Clewsy/gps_clock/README.md

gps_clock has the following features and characteristics:
- 16 digit 7-segment LED display.
- Date/Time display [EPOCH][link_web_wikipedia_epoch_time] format (seconds elapsed since 1970-01-01).
- Date/Time display [ISO-8601][link_web_wikipedia_iso-8601] format (YYYY.MM.DD.HH.MM.SS).
- Adjustable brightness (setting retained with power-cycle).
- Programmable UTC offset from -12hrs to +12hrs in half-hour increments to match any timezone (setting retained with power-cycle).
- RTC with battery back-up to retain time with power-cycle and/or absence of GPS signal.

The [code][link_repo_code], schematics ([control board][link_repo_schematic_control] & [display board][link_repo_schematic_display]) and PCB layouts ([control board][link_repo_pcb_control] & [display board][link_repo_pcb_display]) are all included here on gitlab.

Additional info and photos can be found [here][link_clews_projects_gps_clock].

Proudly mentioned at [hackaday.com][link_web_hackaday_gpsclock] (and linked again in a [later article][link_web_hackaday_iso8601]).

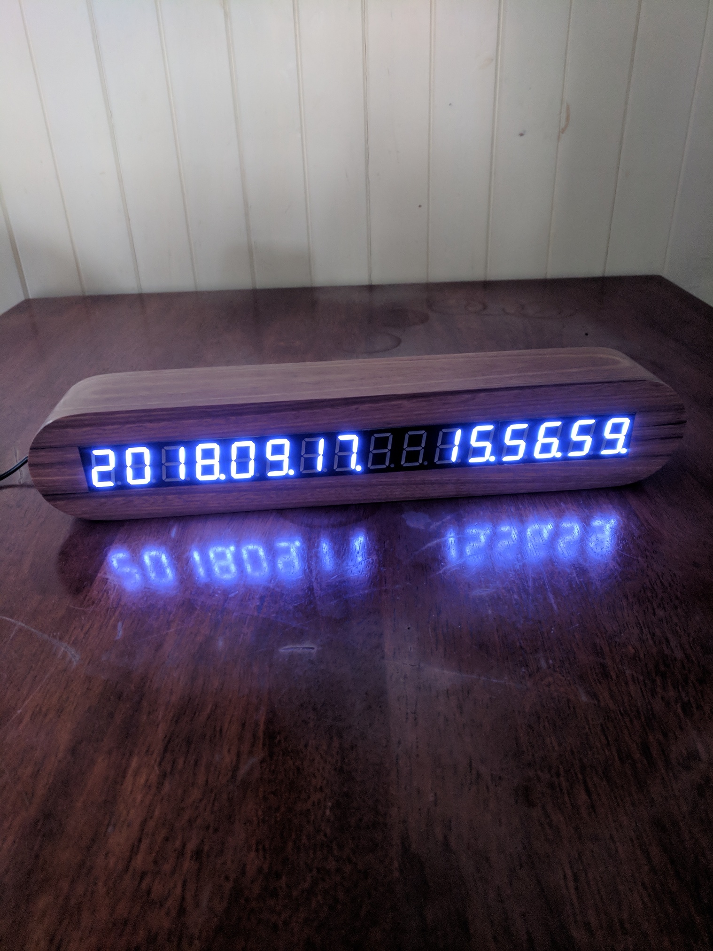
[picture p1: images/gps_clock_github_photo.jpg]
The completed gps_clock.


[link_web_wikipedia_epoch_time]:https://en.wikipedia.org/wiki/Epoch_time
[link_web_wikipedia_iso-8601]:https://en.wikipedia.org/wiki/ISO-8601
[link_web_hackaday_gpsclock]:https://hackaday.com/2018/09/18/epic-clock-clocks-the-unix-epoch/
[link_web_hackaday_iso8601]:https://hackaday.com/2021/04/21/iso-8601-ending-the-date-wars-and-confusing-everyone-equally/
[link_repo_code]:code/
[link_repo_schematic_control]:pcb/schematic_gps_clock_control_board.pdf
[link_repo_schematic_display]:pcb/schematic_gps_clock_display_board.pdf
[link_repo_pcb_display]:pcb/cl0ck_control/
[link_repo_pcb_control]:pcb/cl0ck_display/

[link_clews_projects_gps_clock]:https://clews.pro/projects/gps_clock.php

[image_gps_clock]:images/gps_clock_github_photo.jpg
