Clewsy/gps_clock/pcb/schematic_gps_clock_control_board.pdf

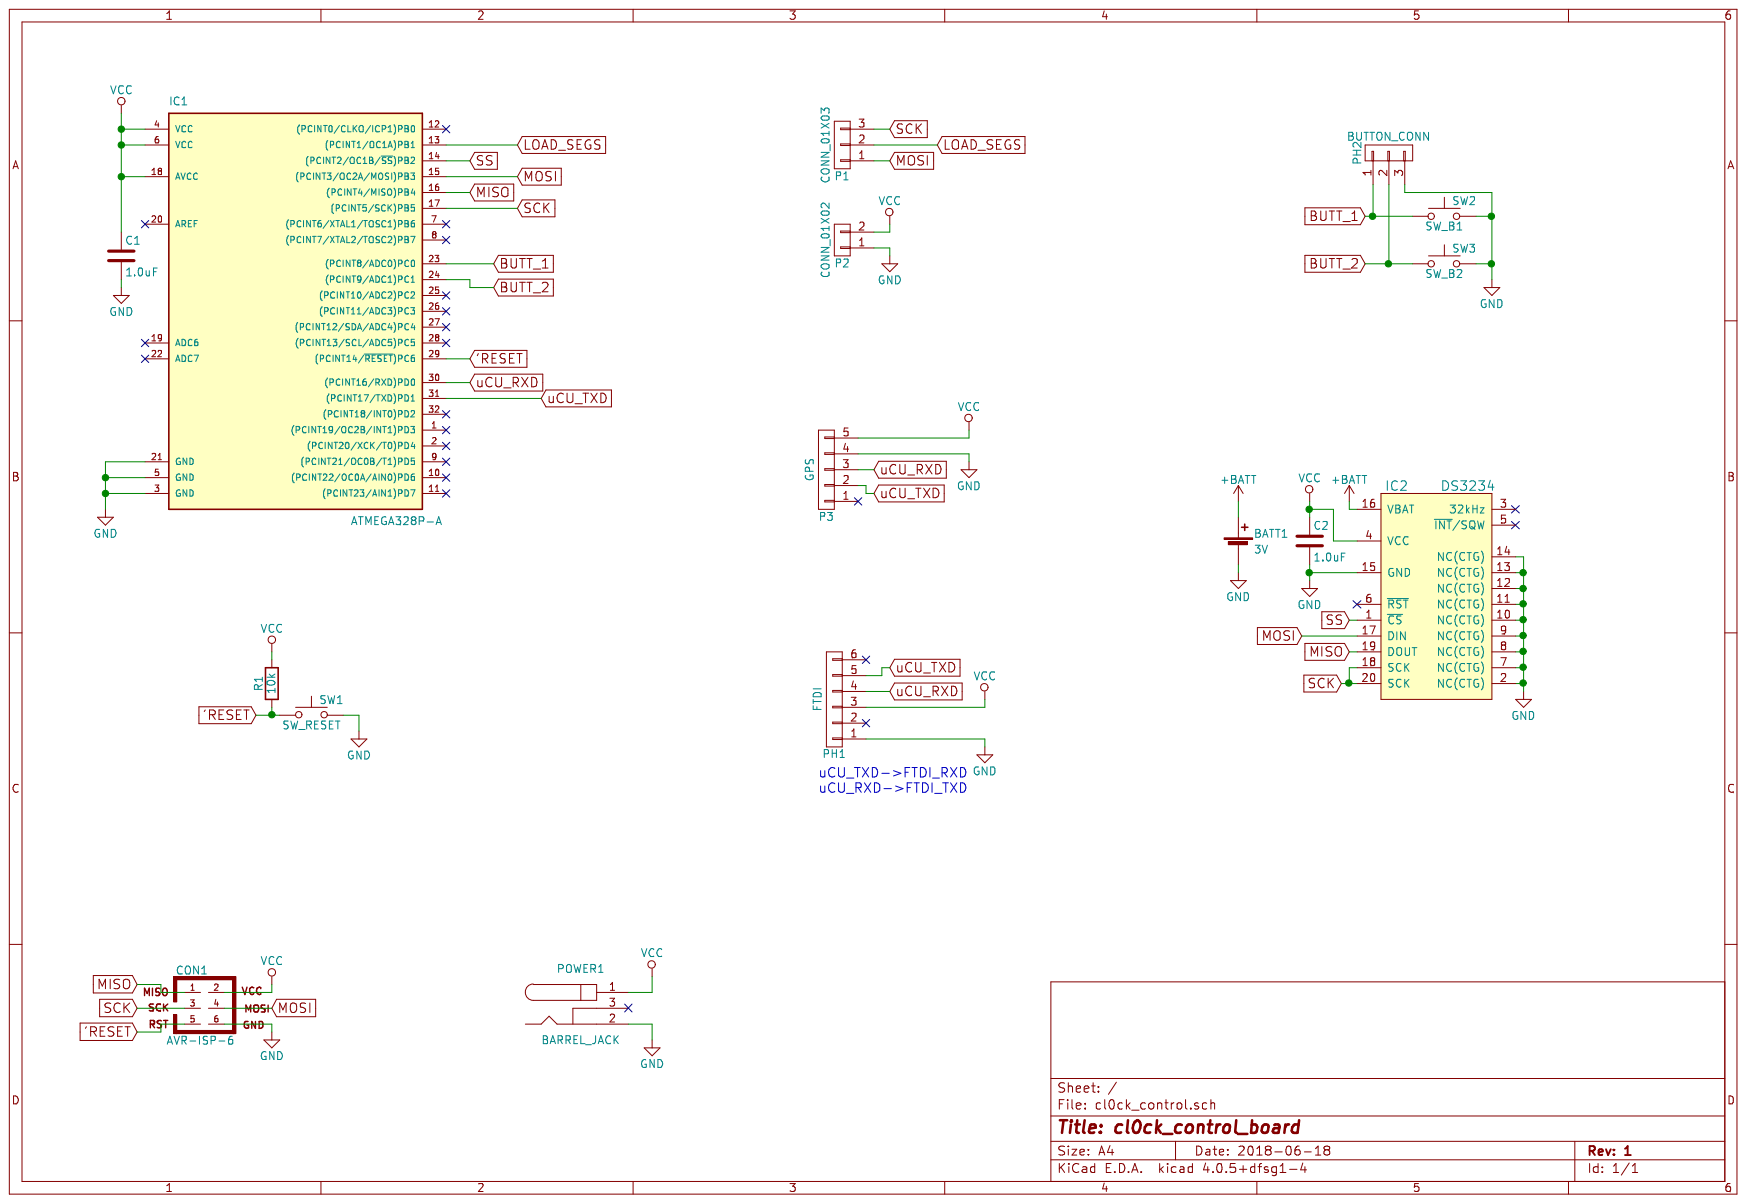
[picture p2: page 1]
