Clewsy/gps_clock/pcb/schematic_gps_clock_display_board.pdf

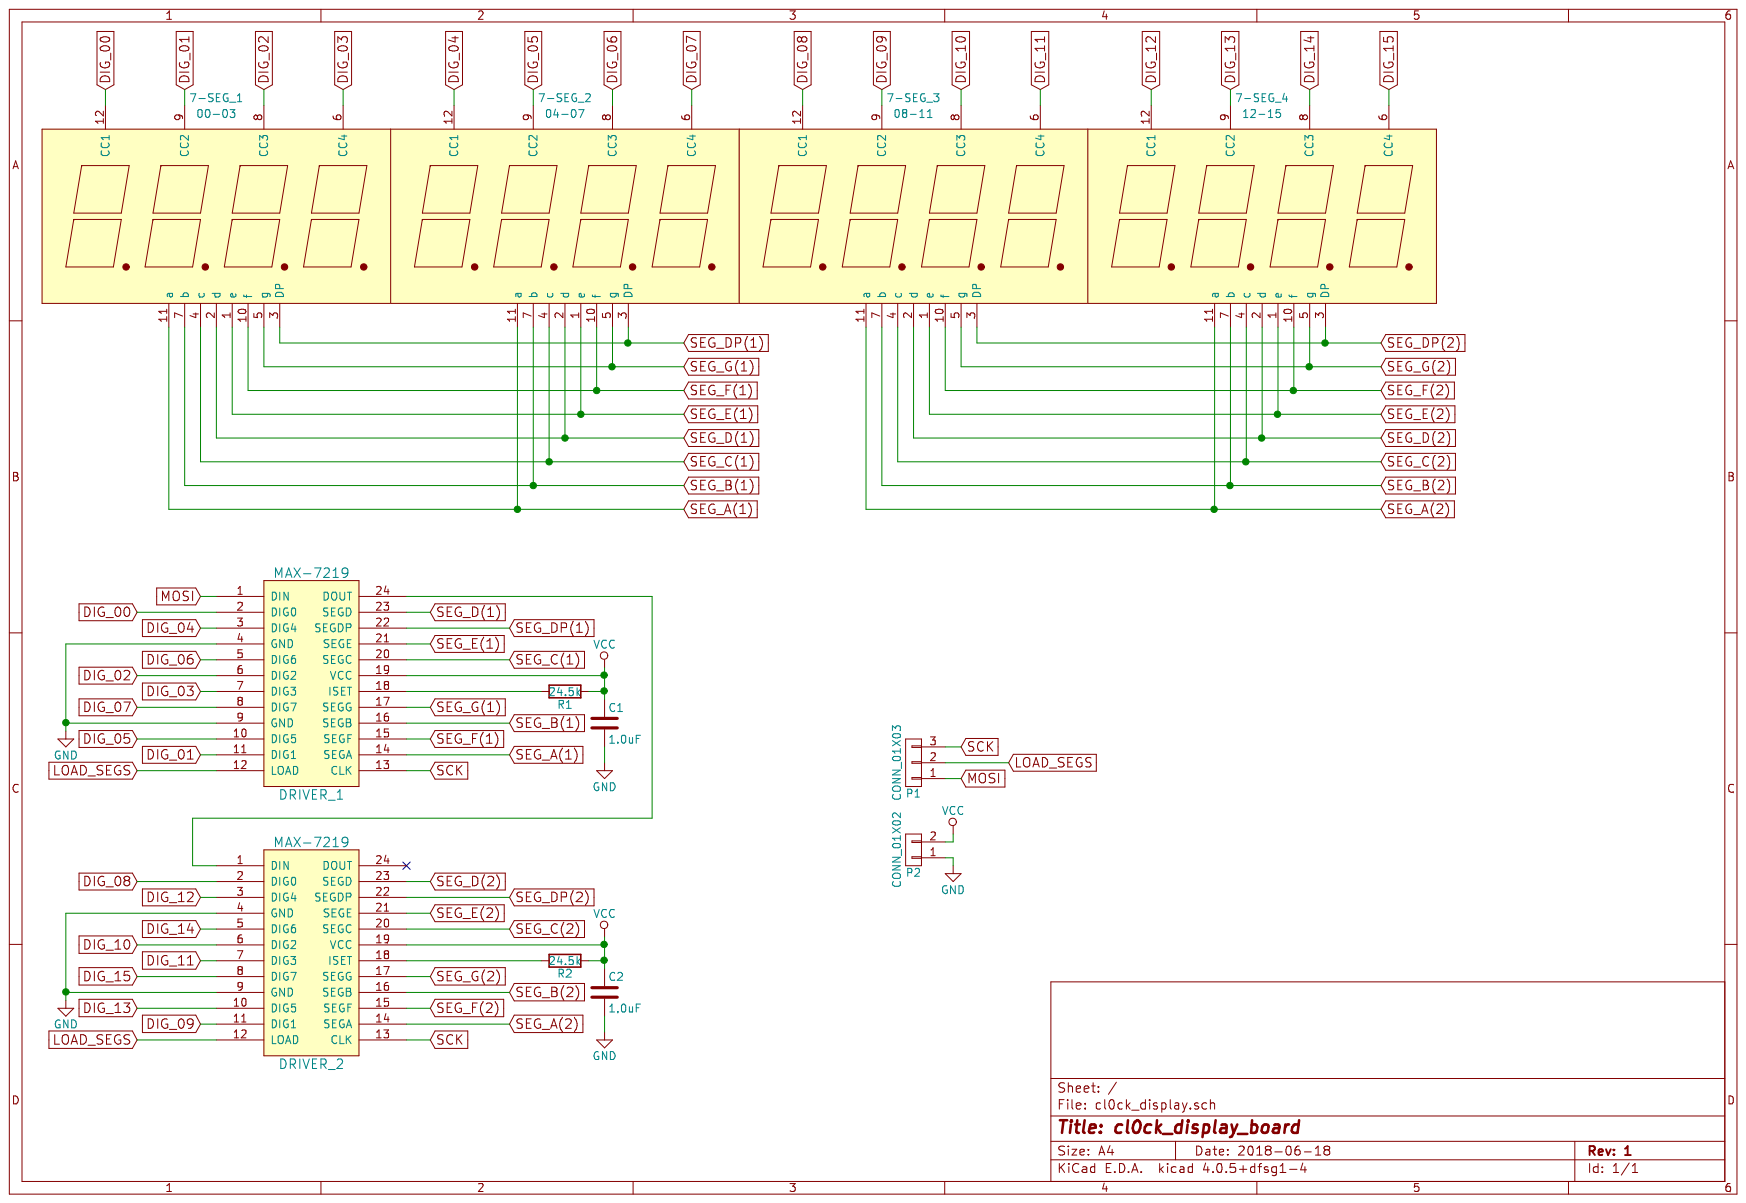
[picture p3: page 1]
