Clewsy/gps_clock/rev_0/PCB (Eagle)/GPSClock_Rev2/GPSClock.pdf

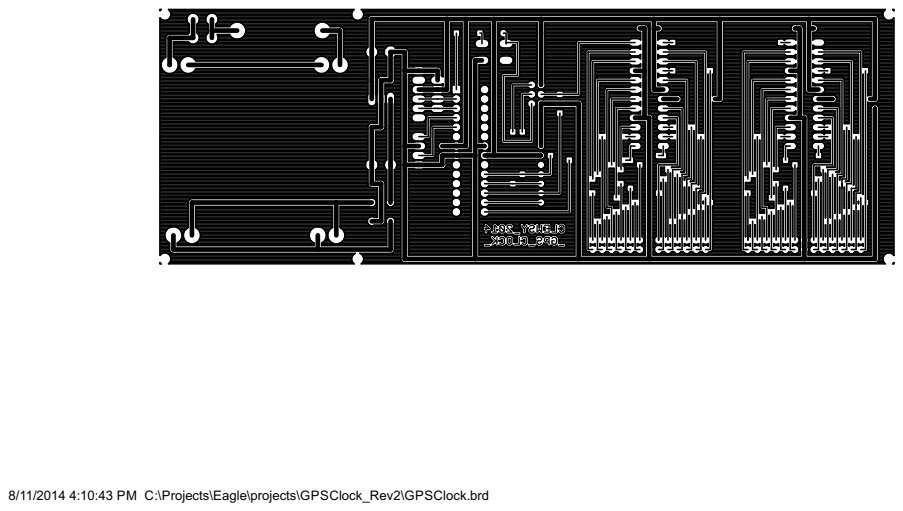
[picture p4: page 1]

8/11/2014 4:10:43 PM C:\Projects\Eagle\projects\GPSClock_Rev2\GPSClock.brd
