Clewsy/gps_clock/pcb/cl0ck_display/cl0ck_display.kicad_pcb

## KiCad design pcb/cl0ck_display/cl0ck_display.kicad_pcb (2019-09-14)

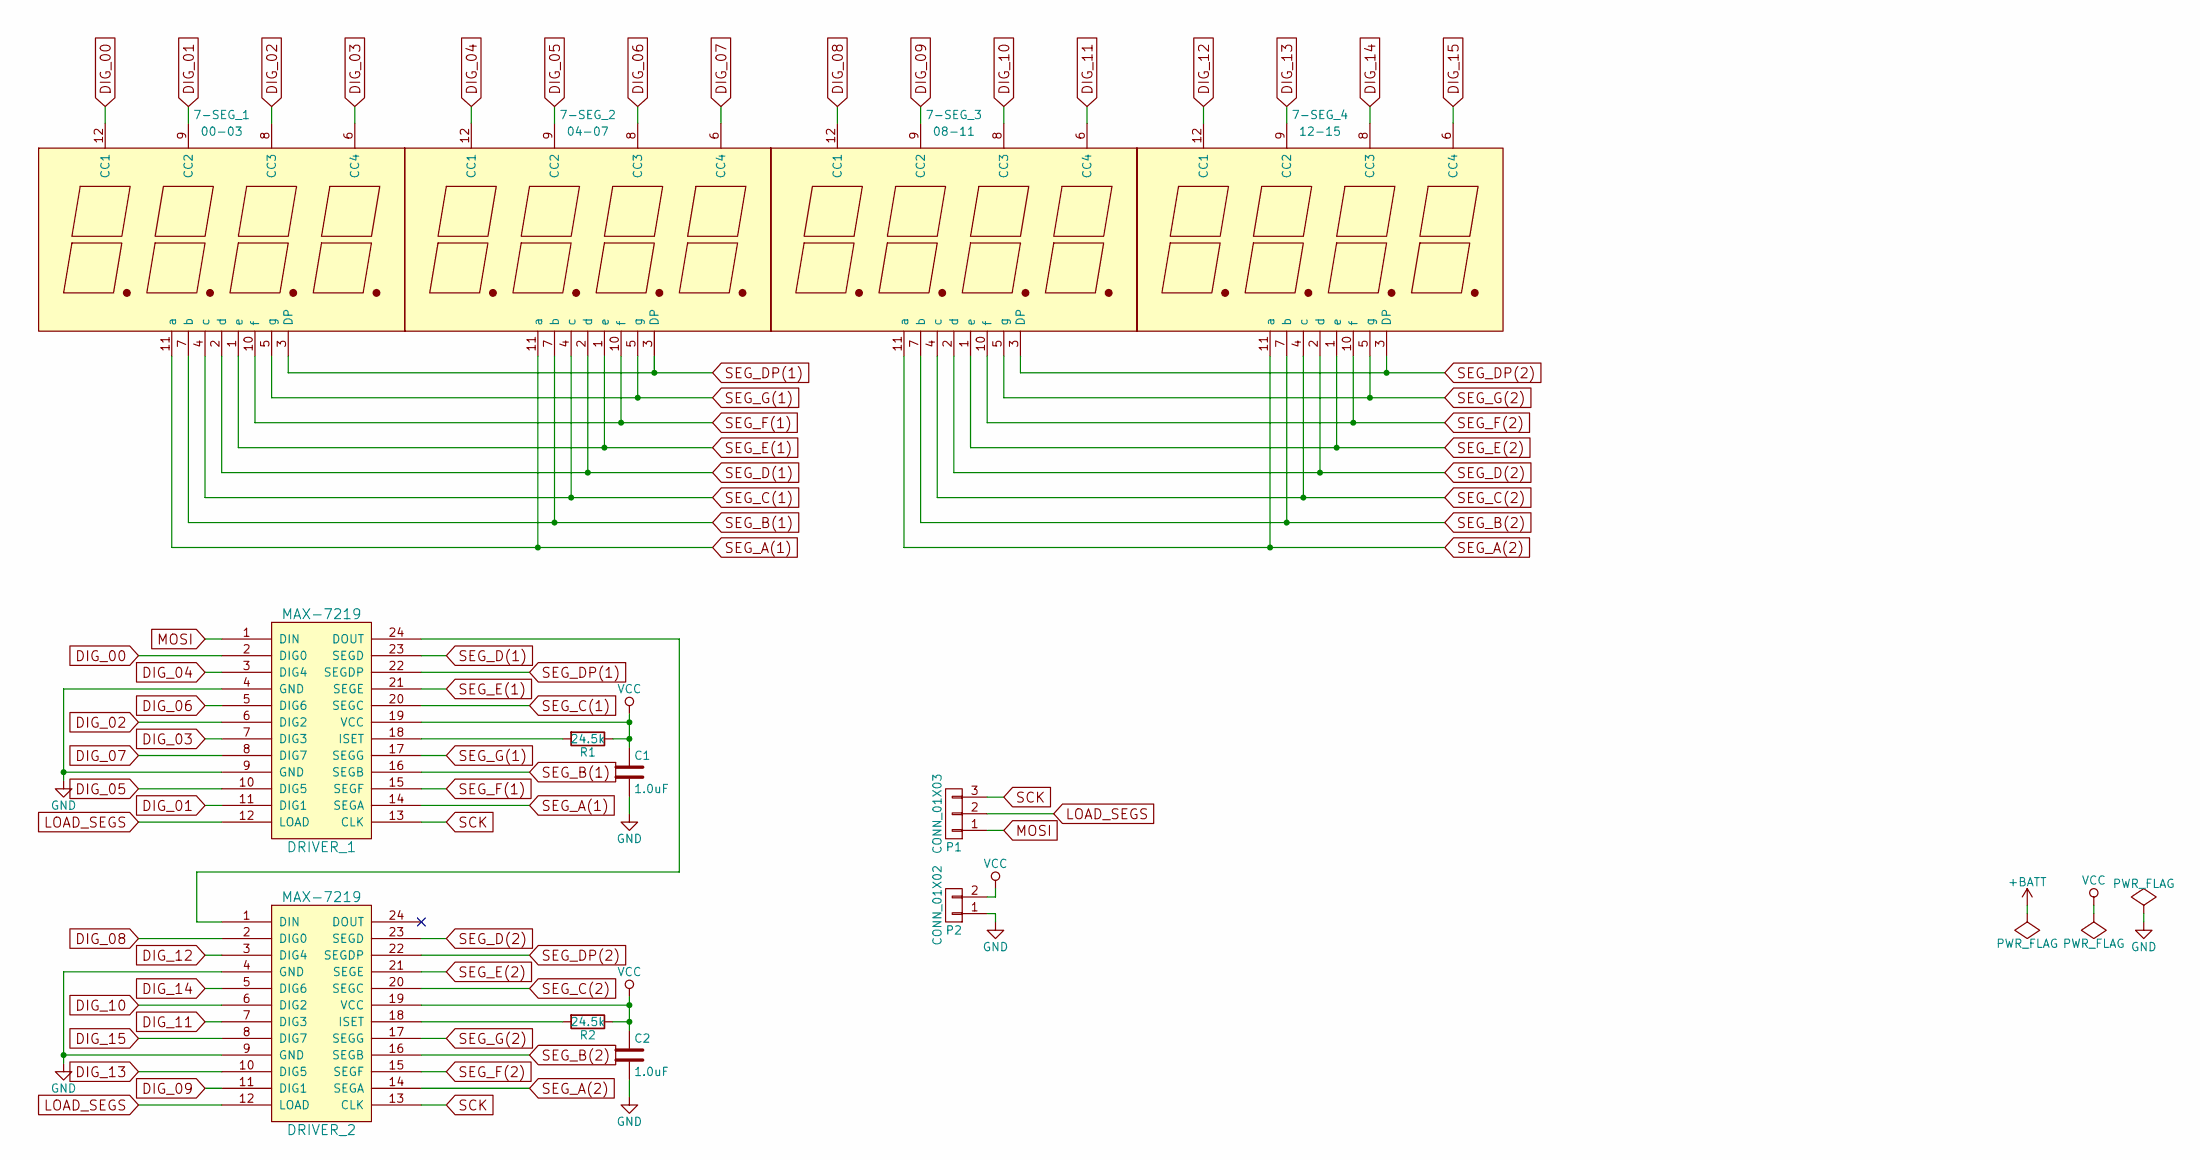
[picture p5: schematic cl0ck_display.sch, cl0ck_display_board]

Parts:
7-SEG_1: 00-03; 4x7-SEG
7-SEG_2: 04-07; 4x7-SEG
7-SEG_3: 08-11; 4x7-SEG
7-SEG_4: 12-15; 4x7-SEG
C1, C2: 1.0uF; C_0603
DRIVER_1, DRIVER_2: MAX-7219; SOIC-24W_7.5x15.4mm_Pitch1.27mm
P1: CONN_01X03; Pin_Header_Straight_1x03
P2: CONN_01X02; Pin_Header_Straight_1x02
R1, R2: 24.5k; R_0603

Connections:
DIG_00: 7-SEG_1.12 (CC1), DRIVER_1.2 (DIG0)
DIG_01: 7-SEG_1.9 (CC2), DRIVER_1.11 (DIG1)
DIG_02: 7-SEG_1.8 (CC3), DRIVER_1.6 (DIG2)
DIG_03: 7-SEG_1.6 (CC4), DRIVER_1.7 (DIG3)
DIG_04: 7-SEG_2.12 (CC1), DRIVER_1.3 (DIG4)
DIG_05: 7-SEG_2.9 (CC2), DRIVER_1.10 (DIG5)
DIG_06: 7-SEG_2.8 (CC3), DRIVER_1.5 (DIG6)
DIG_07: 7-SEG_2.6 (CC4), DRIVER_1.8 (DIG7)
DIG_08: 7-SEG_3.12 (CC1), DRIVER_2.2 (DIG0)
DIG_09: 7-SEG_3.9 (CC2), DRIVER_2.11 (DIG1)
DIG_10: 7-SEG_3.8 (CC3), DRIVER_2.6 (DIG2)
DIG_11: 7-SEG_3.6 (CC4), DRIVER_2.7 (DIG3)
DIG_12: 7-SEG_4.12 (CC1), DRIVER_2.3 (DIG4)
DIG_13: 7-SEG_4.9 (CC2), DRIVER_2.10 (DIG5)
DIG_14: 7-SEG_4.8 (CC3), DRIVER_2.5 (DIG6)
DIG_15: 7-SEG_4.6 (CC4), DRIVER_2.8 (DIG7)
GND: C1.2, C2.2, DRIVER_1.4 (GND), DRIVER_1.9 (GND), DRIVER_2.4 (GND), DRIVER_2.9 (GND), P2.1
LOAD_SEGS: DRIVER_1.12 (LOAD), DRIVER_2.12 (LOAD), P1.2
MOSI: DRIVER_1.1 (DIN), P1.1
unnamed: DRIVER_1.18 (ISET), R1.2
unnamed: DRIVER_1.24 (DOUT), DRIVER_2.1 (DIN)
unnamed: DRIVER_2.18 (ISET), R2.2
SCK: DRIVER_1.13 (CLK), DRIVER_2.13 (CLK), P1.3
SEG_A(1): 7-SEG_1.11 (a), 7-SEG_2.11 (a), DRIVER_1.14 (SEGA)
SEG_A(2): 7-SEG_3.11 (a), 7-SEG_4.11 (a), DRIVER_2.14 (SEGA)
SEG_B(1): 7-SEG_1.7 (b), 7-SEG_2.7 (b), DRIVER_1.16 (SEGB)
SEG_B(2): 7-SEG_3.7 (b), 7-SEG_4.7 (b), DRIVER_2.16 (SEGB)
SEG_C(1): 7-SEG_1.4 (c), 7-SEG_2.4 (c), DRIVER_1.20 (SEGC)
SEG_C(2): 7-SEG_3.4 (c), 7-SEG_4.4 (c), DRIVER_2.20 (SEGC)
SEG_D(1): 7-SEG_1.2 (d), 7-SEG_2.2 (d), DRIVER_1.23 (SEGD)
SEG_D(2): 7-SEG_3.2 (d), 7-SEG_4.2 (d), DRIVER_2.23 (SEGD)
SEG_DP(1): 7-SEG_1.3 (DP), 7-SEG_2.3 (DP), DRIVER_1.22 (SEGDP)
SEG_DP(2): 7-SEG_3.3 (DP), 7-SEG_4.3 (DP), DRIVER_2.22 (SEGDP)
SEG_E(1): 7-SEG_1.1 (e), 7-SEG_2.1 (e), DRIVER_1.21 (SEGE)
SEG_E(2): 7-SEG_3.1 (e), 7-SEG_4.1 (e), DRIVER_2.21 (SEGE)
SEG_F(1): 7-SEG_1.10 (f), 7-SEG_2.10 (f), DRIVER_1.15 (SEGF)
SEG_F(2): 7-SEG_3.10 (f), 7-SEG_4.10 (f), DRIVER_2.15 (SEGF)
SEG_G(1): 7-SEG_1.5 (g), 7-SEG_2.5 (g), DRIVER_1.17 (SEGG)
SEG_G(2): 7-SEG_3.5 (g), 7-SEG_4.5 (g), DRIVER_2.17 (SEGG)
VCC: C1.1, C2.1, DRIVER_1.19 (VCC), DRIVER_2.19 (VCC), P2.2, R1.1, R2.1

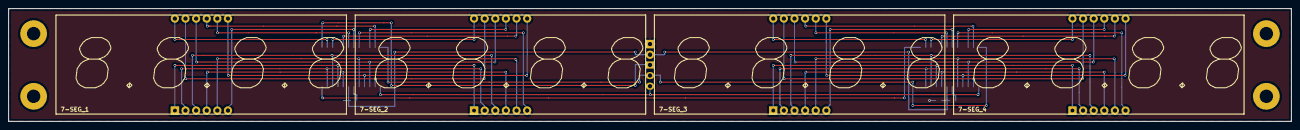
[picture p6: board cl0ck_display.kicad_pcb from above]

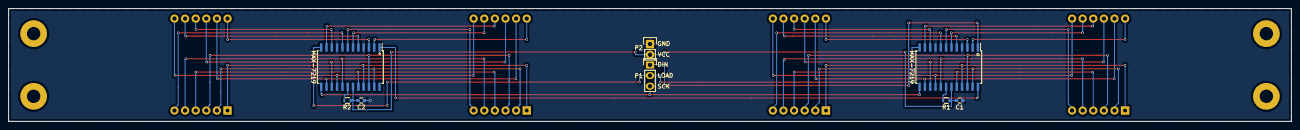
[picture p7: board cl0ck_display.kicad_pcb from below]

Board: 2 copper layers, 307.0 x 27.0 mm, 12 parts (8 on the bottom side), 40 nets.
