Clewsy/gps_clock/pcb/cl0ck_control/cl0ck_control.kicad_pcb

## KiCad design pcb/cl0ck_control/cl0ck_control.kicad_pcb (2018-07-30)

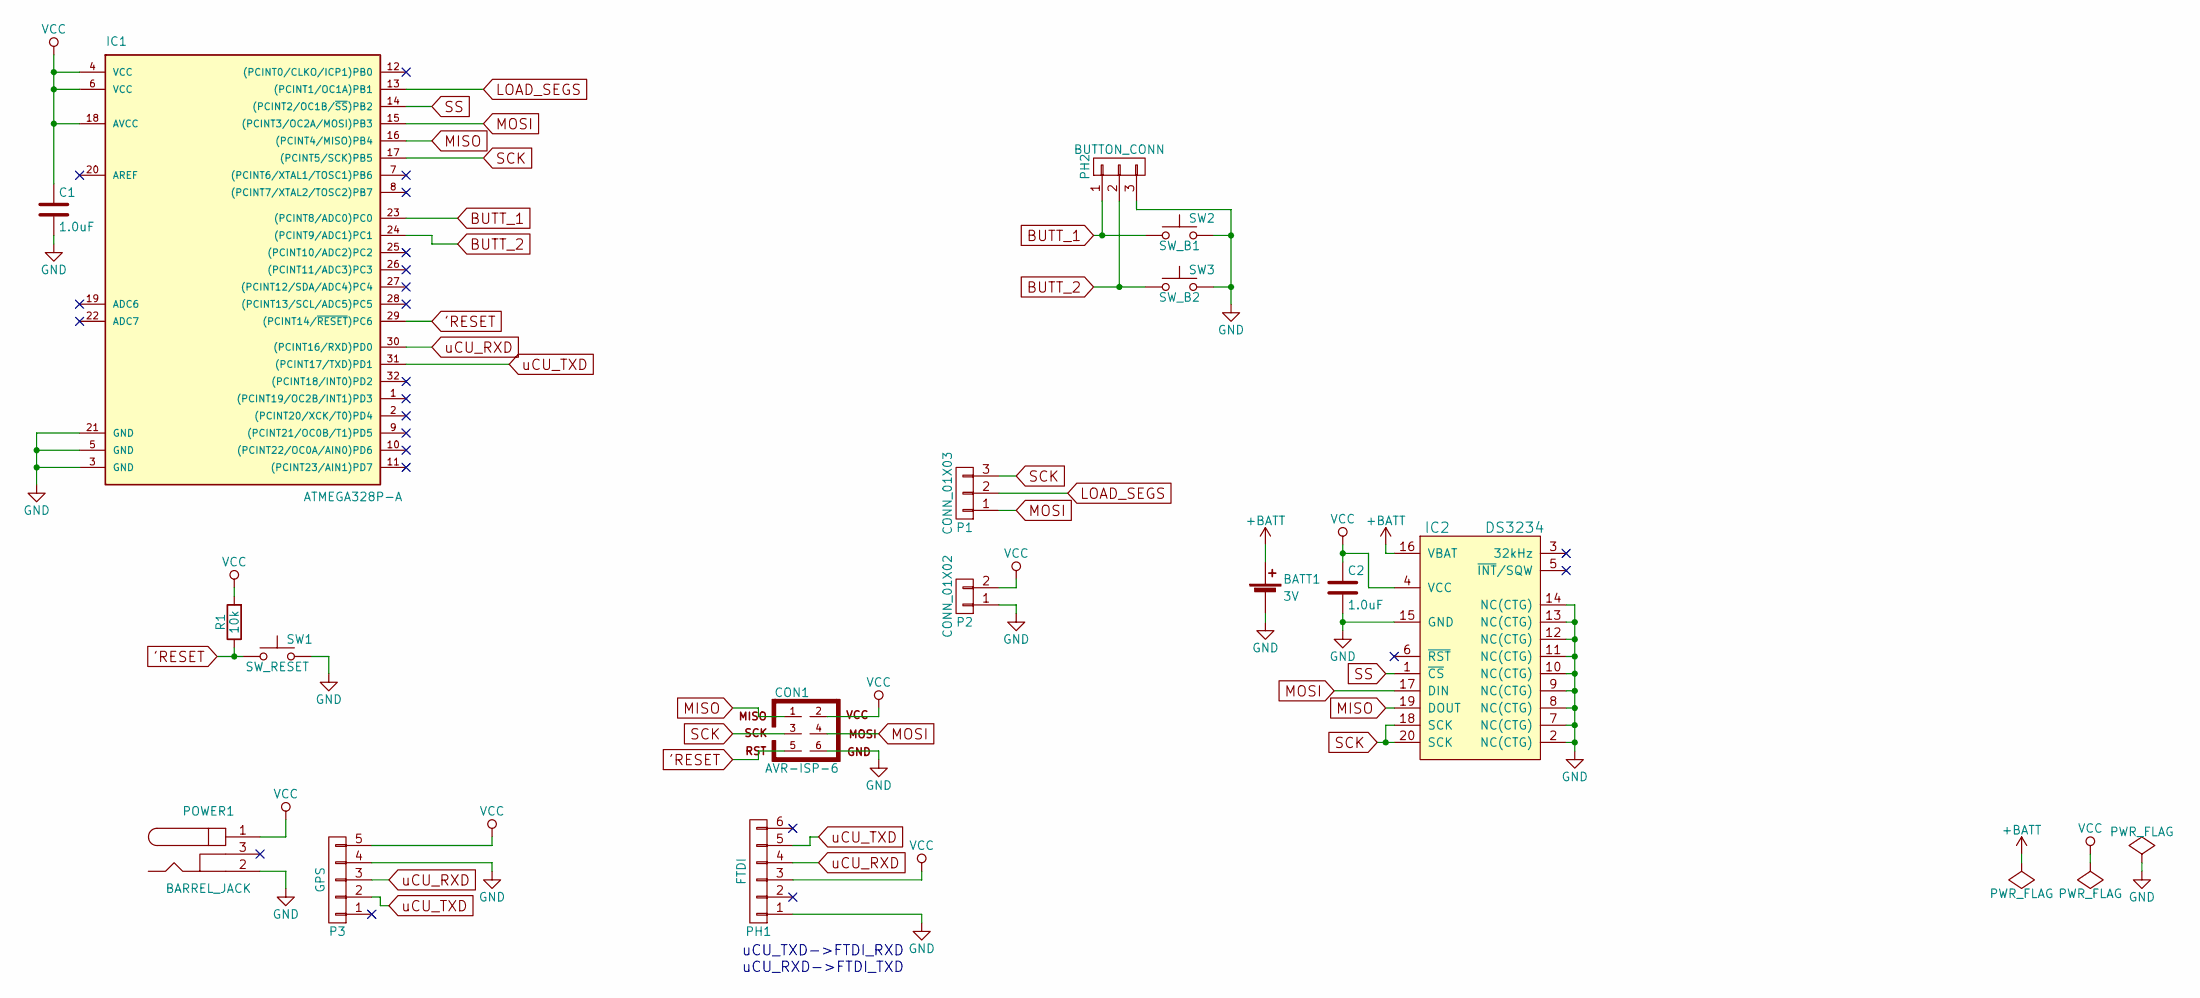
[picture p8: schematic cl0ck_control.sch, cl0ck_control_board]

Parts:
BATT1: 3V; Keystone_3000_1x12mm-CoinCell
C1, C2: 1.0uF; C_0603
CON1: AVR-ISP-6; Pin_Header_Straight_2x03
IC1: ATMEGA328P-A; TQFP-32_7x7mm_Pitch0.8mm
IC2: DS3234; SOIC-20W_7.5x12.8mm_Pitch1.27mm
P1: CONN_01X03; Pin_Header_Straight_1x03
P2: CONN_01X02; Pin_Header_Straight_1x02
P3: GPS; Pin_Header_Straight_1x05
PH1: FTDI; Pin_Header_Angled_1x06
PH2: BUTTON_CONN; Pin_Header_Angled_1x03
POWER1: BARREL_JACK
R1: 10k; R_0603
SW1: SW_RESET; SW_SPST_PTS645
SW2: SW_B1; SW_SPST_PTS645
SW3: SW_B2; SW_SPST_PTS645

Connections:
'RESET: CON1.5, IC1.29 ((PCINT14/~RESET~)PC6), R1.1, SW1.1
+BATT: BATT1.1 (+), IC2.16 (VBAT)
BUTT_1: IC1.23 ((PCINT8/ADC0)PC0), PH2.1, SW2.1
BUTT_2: IC1.24 ((PCINT9/ADC1)PC1), PH2.2, SW3.1
GND: BATT1.2 (-), C1.2, C2.2, CON1.6, IC1.3 (GND), IC1.5 (GND), IC1.21 (GND), IC2.2 (NC(CTG)), IC2.7 (NC(CTG)), IC2.8 (NC(CTG)), IC2.9 (NC(CTG)), IC2.10 (NC(CTG)), IC2.11 (NC(CTG)), IC2.12 (NC(CTG)), IC2.13 (NC(CTG)), IC2.14 (NC(CTG)), IC2.15 (GND), P2.1, P3.4, PH1.1, PH2.3, POWER1.2, SW1.2, SW2.2, SW3.2
LOAD_SEGS: IC1.13 ((PCINT1/OC1A)PB1), P1.2
MISO: CON1.1, IC1.16 ((PCINT4/MISO)PB4), IC2.19 (DOUT)
MOSI: CON1.4, IC1.15 ((PCINT3/OC2A/MOSI)PB3), IC2.17 (DIN), P1.1
SCK: CON1.3, IC1.17 ((PCINT5/SCK)PB5), IC2.18 (SCK), IC2.20 (SCK), P1.3
SS: IC1.14 ((PCINT2/OC1B/~SS~)PB2), IC2.1 (~CS~)
VCC: C1.1, C2.1, CON1.2, IC1.4 (VCC), IC1.6 (VCC), IC1.18 (AVCC), IC2.4 (VCC), P2.2, P3.5, PH1.3, POWER1.1, R1.2
uCU_RXD: IC1.30 ((PCINT16/RXD)PD0), P3.3, PH1.4
uCU_TXD: IC1.31 ((PCINT17/TXD)PD1), P3.2, PH1.5

Notes on the sheet:
uCU_TXD->FTDI_RXD uCU_RXD->FTDI_TXD

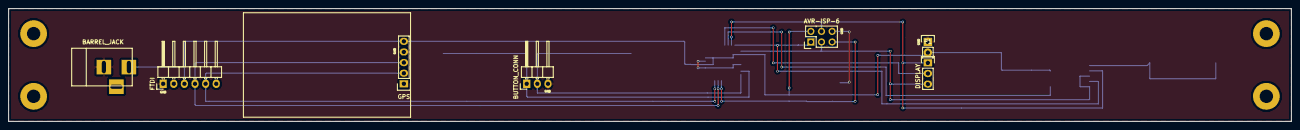
[picture p9: board cl0ck_control.kicad_pcb from above]

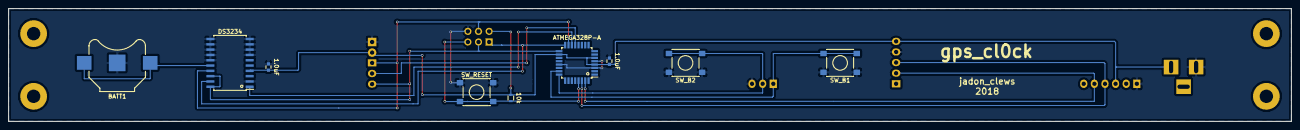
[picture p10: board cl0ck_control.kicad_pcb from below]

Board: 2 copper layers, 307.0 x 27.0 mm, 16 parts (9 on the bottom side), 13 nets.
