Clewsy/gps_clock/rev_0/PCB (Eagle)/GPSClock/GPSClock.brd

## EAGLE design rev_0/PCB (Eagle)/GPSClock/GPSClock.brd (2016-07-20)

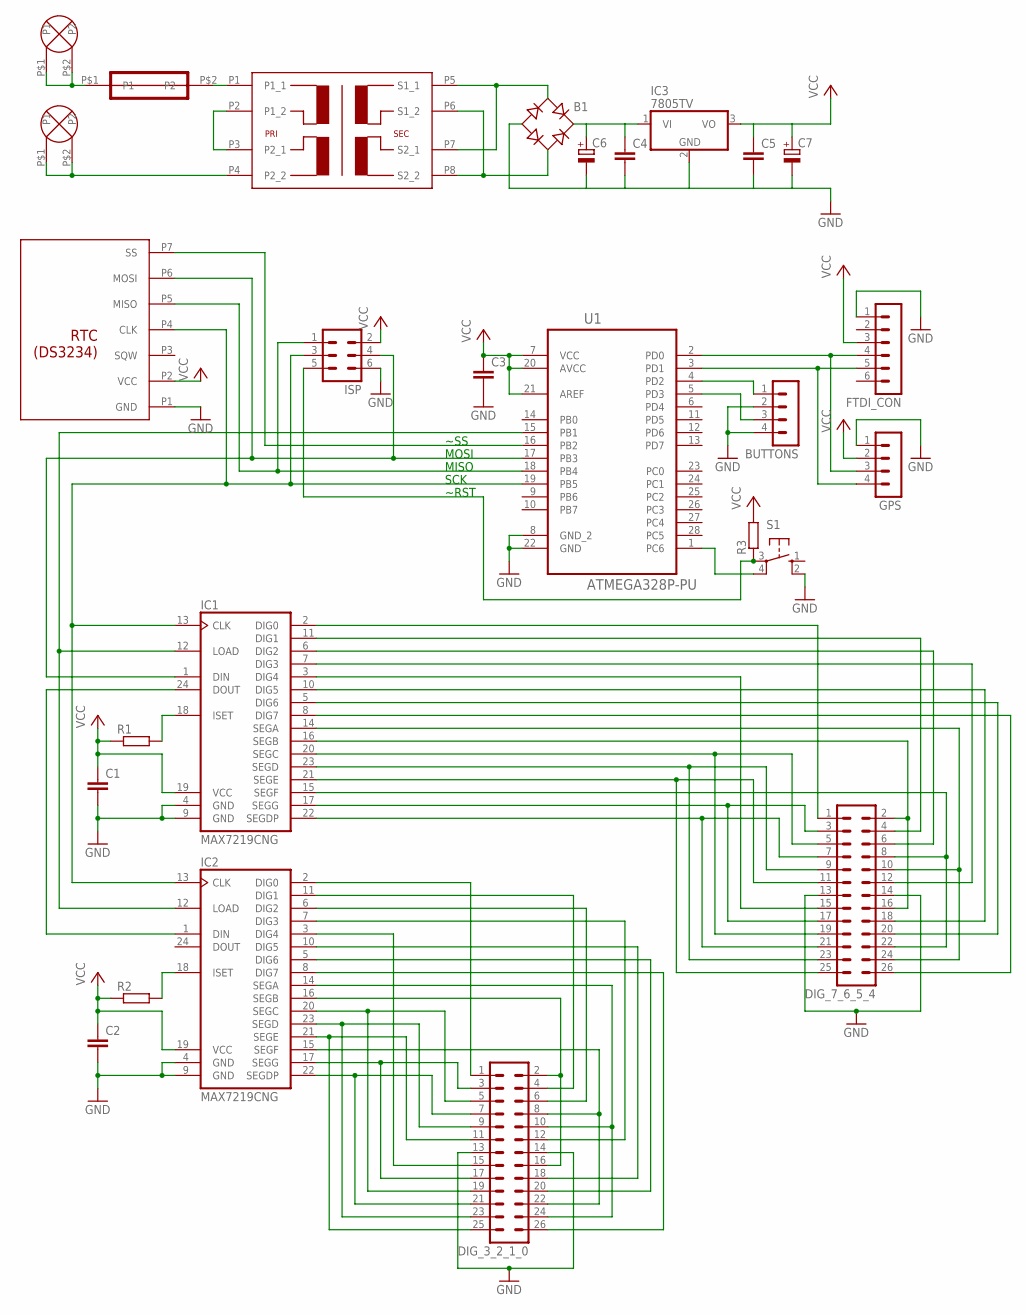
[picture p11: schematic GPSClock.sch]

Parts:
B1: RB1A
BUTTONS: MA04-1
C1, C2, C3, C4, C5: C-EU050-025X075; C050-025X075
C6: CPOL-EUE5-13; E5-13
C7: CPOL-EUE5-10.5; E5-10,5
DIG_3_2_1_0, DIG_7_6_5_4: ML26
FTDI_CON: MA06-1
GPS: MA04-1
IC1, IC2: MAX7219CNG; DIL24-3
IC3: 7805TV; TO220V
ISP: ML6
R1, R2, R3: R-EU_0207/10; 0207/10
S1: 10-XX; B3F-10XX
U1: ATMEGA328P-PU; DIP254P762X457-28
U$1: TRAFO_M4312
U$2, U$3: SPADE_PCB
U$4: FUSE_HOLDER
U$5: RTC

Connections:
GND: B1.-, BUTTONS.2, BUTTONS.4, C1.2, C2.2, C3.2, C4.2, C5.2, C6.-, C7.-, DIG_3_2_1_0.13, DIG_3_2_1_0.14, DIG_7_6_5_4.13, DIG_7_6_5_4.14, FTDI_CON.1, GPS.1, IC1.4 (GND), IC1.9 (GND), IC2.4 (GND), IC2.9 (GND), IC3.2 (GND), ISP.6, S1.2 (S1), U1.8 (GND_2), U1.22 (GND), U$5.P1 (GND)
unnamed: FTDI_CON.4, GPS.3, U1.2 (PD0)
unnamed: FTDI_CON.5, GPS.4, U1.3 (PD1)
unnamed: IC1.13 (CLK), IC2.13 (CLK), ISP.3, U1.19 (PB5), U$5.P4 (CLK)
unnamed: ISP.1, U1.18 (PB4), U$5.P5 (MISO)
unnamed: IC1.1 (DIN), ISP.4, U1.17 (PB3), U$5.P6 (MOSI)
unnamed: U1.16 (PB2), U$5.P7 (SS)
unnamed: IC1.12 (LOAD), IC2.12 (LOAD), U1.15 (PB1)
unnamed: B1.AC1, U$1.P5 (S1_1), U$1.P7 (S2_1)
unnamed: IC1.18 (ISET), R1.2
unnamed: IC2.18 (ISET), R2.2
unnamed: IC1.24 (DOUT), IC2.1 (DIN)
unnamed: DIG_3_2_1_0.1, IC2.2 (DIG0)
unnamed: DIG_3_2_1_0.3, DIG_3_2_1_0.17, IC2.17 (SEGG)
unnamed: DIG_3_2_1_0.5, DIG_3_2_1_0.19, IC2.20 (SEGC)
unnamed: DIG_3_2_1_0.7, DIG_3_2_1_0.21, IC2.22 (SEGDP)
unnamed: DIG_3_2_1_0.9, DIG_3_2_1_0.23, IC2.23 (SEGD)
unnamed: DIG_3_2_1_0.11, DIG_3_2_1_0.25, IC2.21 (SEGE)
unnamed: DIG_3_2_1_0.15, IC2.3 (DIG4)
unnamed: DIG_3_2_1_0.2, DIG_3_2_1_0.16, IC2.16 (SEGB)
unnamed: DIG_3_2_1_0.4, IC2.11 (DIG1)
unnamed: DIG_3_2_1_0.6, IC2.6 (DIG2)
unnamed: DIG_3_2_1_0.8, DIG_3_2_1_0.22, IC2.15 (SEGF)
unnamed: DIG_3_2_1_0.10, DIG_3_2_1_0.24, IC2.14 (SEGA)
unnamed: DIG_3_2_1_0.12, IC2.7 (DIG3)
unnamed: DIG_3_2_1_0.18, IC2.10 (DIG5)
unnamed: DIG_3_2_1_0.20, IC2.5 (DIG6)
unnamed: DIG_3_2_1_0.26, IC2.8 (DIG7)
unnamed: DIG_7_6_5_4.1, IC1.2 (DIG0)
unnamed: DIG_7_6_5_4.3, DIG_7_6_5_4.17, IC1.17 (SEGG)
unnamed: DIG_7_6_5_4.5, DIG_7_6_5_4.19, IC1.20 (SEGC)
unnamed: DIG_7_6_5_4.7, DIG_7_6_5_4.21, IC1.22 (SEGDP)
unnamed: DIG_7_6_5_4.9, DIG_7_6_5_4.23, IC1.23 (SEGD)
unnamed: DIG_7_6_5_4.11, DIG_7_6_5_4.25, IC1.21 (SEGE)
unnamed: DIG_7_6_5_4.15, IC1.3 (DIG4)
unnamed: DIG_7_6_5_4.2, DIG_7_6_5_4.16, IC1.16 (SEGB)
unnamed: DIG_7_6_5_4.4, IC1.11 (DIG1)
unnamed: DIG_7_6_5_4.6, IC1.6 (DIG2)
unnamed: DIG_7_6_5_4.8, DIG_7_6_5_4.22, IC1.15 (SEGF)
unnamed: DIG_7_6_5_4.10, DIG_7_6_5_4.24, IC1.14 (SEGA)
unnamed: DIG_7_6_5_4.12, IC1.7 (DIG3)
unnamed: DIG_7_6_5_4.18, IC1.10 (DIG5)
unnamed: DIG_7_6_5_4.20, IC1.5 (DIG6)
unnamed: DIG_7_6_5_4.26, IC1.8 (DIG7)
unnamed: U$3.P$1 (P1), U$3.P$2 (P2), U$4.P$1 (P1)
unnamed: ISP.5, R3.1, S1.3
unnamed: BUTTONS.1, U1.4 (PD2)
unnamed: BUTTONS.3, U1.5 (PD3)
unnamed: S1.4 (P1), U1.1 (PC6)
unnamed: U$1.P2 (P1_2), U$1.P3 (P2_1)
unnamed: B1.+, C4.1, C6.+, IC3.1 (VI)
unnamed: U$1.P1 (P1_1), U$4.P$2 (P2)
unnamed: U$1.P4 (P2_2), U$2.P$1 (P1), U$2.P$2 (P2)
TRAN: B1.AC2, U$1.P6 (S1_2), U$1.P8 (S2_2)
VCC: C1.1, C2.1, C3.1, C5.1, C7.+, FTDI_CON.3, GPS.2, IC1.19 (VCC), IC2.19 (VCC), IC3.3 (VO), ISP.2, R1.1, R2.1, R3.2, U1.7 (VCC), U1.20 (AVCC), U1.21 (AREF), U$5.P2 (VCC)

Notes on the sheet:
~RST
SCK
MISO
MOSI
~SS

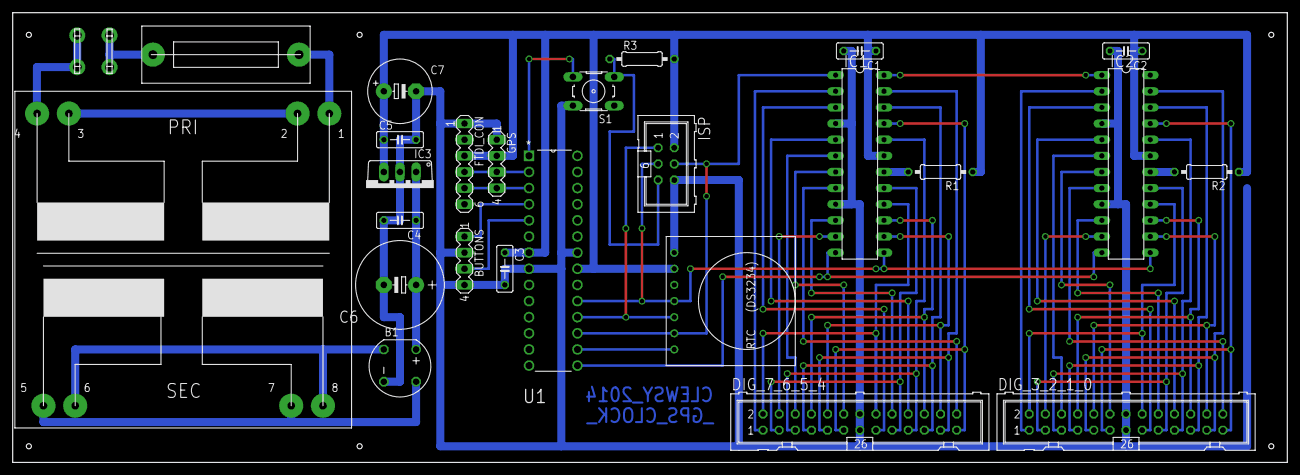
[picture p12: board GPSClock.brd from above]

Board: 2 copper layers, 200.6 x 70.8 mm, 27 parts (0 on the bottom side), 55 nets.
