Clewsy/gps_clock/rev_0/PCB (Eagle)/GPSClock_Rev2/GPSClock_Display.brd

## EAGLE design rev_0/PCB (Eagle)/GPSClock_Rev2/GPSClock_Display.brd (2016-07-20)

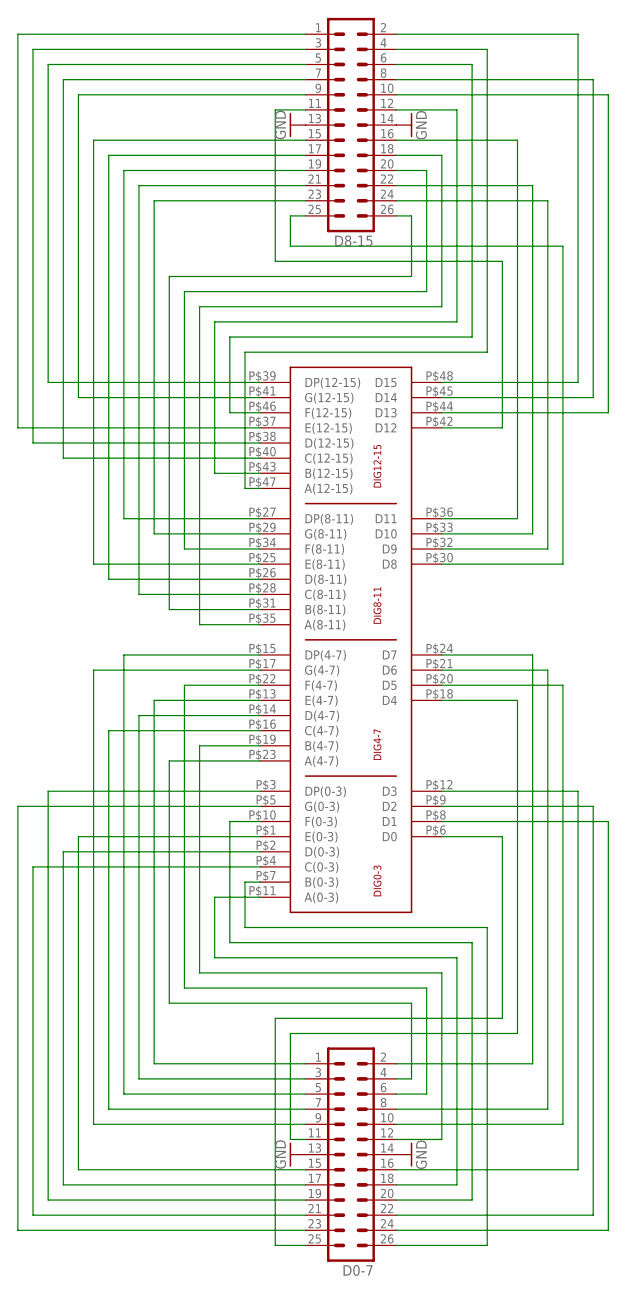
[picture p13: schematic GPSClock_Display.sch]

Parts:
D0-7, D8-15: MA13-2
U$1: 4X7X4_SEG

Connections:
GND: D0-7.13, D0-7.14, D8-15.13, D8-15.14
unnamed: D0-7.1, U$1.P$13 (E(4-7))
unnamed: D0-7.3, U$1.P$14 (D(4-7))
unnamed: D0-7.5, U$1.P$15 (DP(4-7))
unnamed: D0-7.7, U$1.P$16 (C(4-7))
unnamed: D0-7.9, U$1.P$17 (G(4-7))
unnamed: D0-7.11, U$1.P$18 (D4)
unnamed: D0-7.15, U$1.P$1 (E(0-3))
unnamed: D0-7.17, U$1.P$2 (D(0-3))
unnamed: D0-7.19, U$1.P$3 (DP(0-3))
unnamed: D0-7.21, U$1.P$4 (C(0-3))
unnamed: D0-7.23, U$1.P$5 (G(0-3))
unnamed: D0-7.25, U$1.P$6 (D0)
unnamed: D0-7.2, U$1.P$24 (D7)
unnamed: D0-7.4, U$1.P$23 (A(4-7))
unnamed: D0-7.6, U$1.P$22 (F(4-7))
unnamed: D0-7.8, U$1.P$21 (D6)
unnamed: D0-7.10, U$1.P$20 (D5)
unnamed: D0-7.12, U$1.P$19 (B(4-7))
unnamed: D0-7.16, U$1.P$12 (D3)
unnamed: D0-7.18, U$1.P$11 (A(0-3))
unnamed: D0-7.20, U$1.P$10 (F(0-3))
unnamed: D0-7.22, U$1.P$9 (D2)
unnamed: D0-7.24, U$1.P$8 (D1)
unnamed: D0-7.26, U$1.P$7 (B(0-3))
unnamed: D8-15.25, U$1.P$30 (D8)
unnamed: D8-15.23, U$1.P$29 (G(8-11))
unnamed: D8-15.21, U$1.P$28 (C(8-11))
unnamed: D8-15.19, U$1.P$27 (DP(8-11))
unnamed: D8-15.17, U$1.P$26 (D(8-11))
unnamed: D8-15.15, U$1.P$25 (E(8-11))
unnamed: D8-15.11, U$1.P$42 (D12)
unnamed: D8-15.9, U$1.P$41 (G(12-15))
unnamed: D8-15.7, U$1.P$40 (C(12-15))
unnamed: D8-15.5, U$1.P$39 (DP(12-15))
unnamed: D8-15.3, U$1.P$38 (D(12-15))
unnamed: D8-15.1, U$1.P$37 (E(12-15))
unnamed: D8-15.26, U$1.P$31 (B(8-11))
unnamed: D8-15.24, U$1.P$32 (D9)
unnamed: D8-15.22, U$1.P$33 (D10)
unnamed: D8-15.20, U$1.P$34 (F(8-11))
unnamed: D8-15.18, U$1.P$35 (A(8-11))
unnamed: D8-15.16, U$1.P$36 (D11)
unnamed: D8-15.12, U$1.P$43 (B(12-15))
unnamed: D8-15.10, U$1.P$44 (D13)
unnamed: D8-15.8, U$1.P$45 (D14)
unnamed: D8-15.6, U$1.P$46 (F(12-15))
unnamed: D8-15.4, U$1.P$47 (A(12-15))
unnamed: D8-15.2, U$1.P$48 (D15)

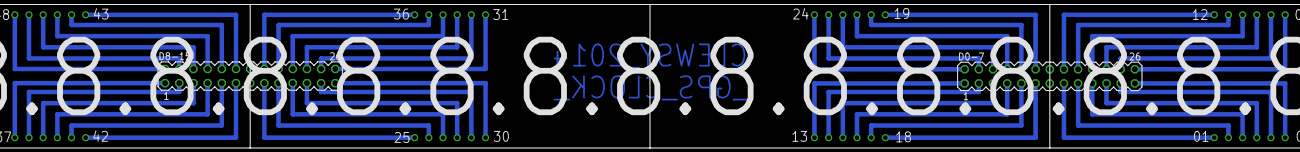
[picture p14: board GPSClock_Display.brd from above]

Board: 2 copper layers, 3 parts (0 on the bottom side), 49 nets.
