Clewsy/gps_clock/(commit log)

2018-06-18 Began iteration to rev_1.
    [GPSClock.brd, GPSClock.sch, GPSClock_Display.brd, GPSClock_Display.sch, cl0ck.sch]
2018-06-18 Split schematic into two separate boards.
    [cl0ck.sch, cl0ck_control.sch, cl0ck_display.sch]
2018-06-18 Created display PCB from schematic.
    [cl0ck_display.kicad_pcb, cl0ck_display.sch]
2018-06-18 Working on control pcb.
    [cl0ck_control.kicad_pcb, cl0ck_control.sch]
2018-06-19 Revision to control pcb.
    [cl0ck_control.kicad_pcb, cl0ck_display.kicad_pcb]
2018-06-19 Revision to pcbs.
    [cl0ck_display.kicad_pcb]
2018-07-25 Prototype display board PCB fabricated. One error found - decoupling capacitor not grounded. Iterated pcb layout to remedy (added via).
    [cl0ck_display.kicad_pcb]
2018-07-25 Display circuit board assembled and functioning. Begun reworking the code. Implemented USART, SPI and MAX7219 driver.
    [gps_clock.c, max7219.c, max7219.h, spi.c, spi.h, usart.c, usart.h]
2018-07-30 Revised control schematic and PCB files. Finalised and ordered first trial run.
    [cl0ck_control.kicad_pcb, cl0ck_control.sch]
2018-08-07 Added some error-checking when syncing time from gps. Also other tweaks.
    [gps_clock.c, gps_clock.h]
2018-08-23 Control PCB assembled and working. Coded implementation of RTC (ds3234) comms.
2018-08-24 Implemented pin-change interrupt triggered by button press (can now cycle through display modes by button).
2018-08-24 Fixed loop when pressing mode button.
    [gps_clock.c, gps_clock.h]
2018-09-03 Implemented a function for printing psuedo 'text' to the display (e.g. 'SynCIng'
2018-09-05 Implemented sync button to initiate an attempt at syncing time to GPS. Fixed errors in PCint vector.
    [ds3234.c, gps_clock.c, gps_clock.h, max7219.c, max7219.h]
2018-09-05 Can set a UTC offset hours value. Offset currently has no effect on time and is not retained with power-cycle (TBD).
2018-09-05 Added comments and broke up some functions for readability.
    [gps_clock.c, gps_clock.h]
2018-09-07 Added a fifth mode to allow setting display intensity (brightness). Currently has no effect (TBD)
2018-09-15 Tidied schematics and generated pdfs.
    [cl0ck_control.sch]
2018-09-22 Tweaked the PCINT ISR and de-bounce value to work better with these mushy buttons.
2018-10-19 Fixed an error in date rollover when adjusting for UTC offset.
    [gps_clock.c]
2019-09-14 Tweaked PCB before second time ordering fab.
    [cl0ck_display.kicad_pcb]
2020-04-09 Restructured repo.
    [GPSClock.brd, GPSClock.sch, GPSClock_Display.brd, GPSClock_Display.sch]
2020-04-09 Compressed rev0.
    [GPSClock.brd, GPSClock.sch, GPSClock_Display.brd, GPSClock_Display.sch]
